greatfet-hardware/gladiolus/(commit log)

2019-01-18 Added AC/DC coupling switch and removed central header
    [gladiolus.kicad_pcb, gladiolus.sch]
2019-01-22 Added transistor notes
    [gladiolus.sch]
2019-01-22 SPI routing
    [foxglove.sch]
2019-01-31 Added AC/DC coupling switch using 74LVC1G3157
    [gladiolus.kicad_pcb, gladiolus.sch]
2019-02-05 Added TODO design notes
    [gladiolus.sch]
2019-02-12 BOM: Changed SMA connectors to RP-SMA and changed SPORT header
    [luckybamboo.kicad_pcb, luckybamboo.sch]
2019-02-28 Gladiolus: Added AD/DC coupling switch, removed DNP components for inversion, added switch to fully turn off TX, routed TX LED current to ADC
    [gladiolus.kicad_pcb, gladiolus.sch]
2019-03-08 Minor change to Gladiolus silkscreen. Began designing Foxglove level shifters / comparators and power supplies.
    [foxglove.sch, gladiolus.kicad_pcb, gladiolus.sch, power_supplies.sch, shifters.sch]
2019-03-11 Changed Changed SPI CS 3 and IRQ1 3 pins, which were interfering with SPIFI. Added DC blocking capacitors near TX switch
    [luckybamboo.kicad_pcb, luckybamboo.sch]
2019-03-18 Lucky Bamboo: Rerouted RX RF signals and rearranged schematic to be consistent with layout. Gladiolus: Routed incomplete signal near TX transistor.
    [gladiolus.kicad_pcb, gladiolus.sch, luckybamboo.kicad_pcb, luckybamboo.sch]
2019-03-26 Replaced rescued symbols on Gladiolus and Lucky Bamboo. Lucky Bamboo: Shorted IRQ1/IRQ2 jumpers to create default connections.
    [gladiolus.kicad_pcb, gladiolus.sch, luckybamboo.kicad_pcb, luckybamboo.sch]
2019-03-27 Lucky Bamboo: Fixed sharp routing corner near splitter to U1
    [luckybamboo.kicad_pcb]
2019-04-09 Corrected component value/manufacturer/part number for C28
    [gladiolus.sch]
2019-04-10 Rerouted ADC trace to improve ground plane connectivity
    [gladiolus.kicad_pcb]
2019-04-11 Changed switch to turn off TX while the DAC is in sleep mode.
    [gladiolus.kicad_pcb, gladiolus.sch]
2019-04-16 Removed several DNP components
    [gladiolus.sch]
2019-04-16 point to new kicad library
2019-04-16 added notes
    [gladiolus.sch]
2019-04-18 Gladiolus: Added design notes. Removed old TX switch and added new TX switch.
    [gladiolus.sch]
2019-04-22 Gladiolus: Added test points, switched connections on RV1, moved TX shutoff switch position, changed RX switch control pin from SPIFI pin J2.37
    [gladiolus.kicad_pcb, gladiolus.sch]
2019-04-24 Changed TX switch control to J1_24 and the ADC clock to J2_P6
    [gladiolus.kicad_pcb, gladiolus.sch]
2019-05-01 Gladiolus: Added EEPROM and changed to default DAC control for second RX gain stage
    [gladiolus.kicad_pcb, gladiolus.sch]
2019-05-07 Added design notes for test points, EEPROM
    [gladiolus.kicad_pcb, gladiolus.sch]
2019-05-13 Added test points, changed EEPROM package and connections.
    [gladiolus.kicad_pcb, gladiolus.sch]
2019-05-14 Added VDBS voltage range note to schematic
    [gladiolus.kicad_pcb, gladiolus.sch]
2019-05-21 Gladiolus: Changed AC/DC coupling note
    [gladiolus.sch]
2019-05-27 split gladiolus into separate repository
    [azalea.kicad_pcb, azalea.sch, begonia.kicad_pcb, begonia.sch, crocus.kicad_pcb, crocus.sch, daffodil.kicad_pcb, daffodil.sch]
2019-05-29 Updated schematic symbols for J7 and mounting holes
    [gladiolus.sch]
2019-06-14 Added I2C DAC and new ACDC coupling switches to schematic. Began routing.
    [gladiolus.kicad_pcb, gladiolus.sch]
2019-06-17 Completed routing for new ACDC coupling switches
    [gladiolus.kicad_pcb, gladiolus.sch]
2019-06-18 Corrected unconnected VCC net
    [gladiolus.kicad_pcb]
2019-06-19 Corrected ACDC switching scheme and moved test point pads.
    [gladiolus.kicad_pcb, gladiolus.sch]
2019-06-25 Simplified BOM by reducing # of different parts
    [gladiolus.kicad_pcb, gladiolus.sch]
2019-06-25 Corrected SS date
    [gladiolus.kicad_pcb]
2019-06-25 Corrected DRC errors (test points on forbidden layers, track clearance)
    [gladiolus.kicad_pcb]
2019-08-01 Added switch to control bonus row ADC connection, pull-ups/downs for switches, removed pot RV2, improved GND/VCC plane connectivity.
    [gladiolus.kicad_pcb, gladiolus.sch]
2019-08-03 remove VBUS bias option for photodiode clean up some of the layout
    [gladiolus.kicad_pcb, gladiolus.sch]
2019-08-13 remove DNP parts R22, R26, R29 clean up some layout
    [gladiolus.kicad_pcb, gladiolus.sch]
2019-08-13 change C30, C31, R21 from 0402 to 0603 clean up more layout
    [gladiolus.kicad_pcb, gladiolus.sch]
2019-08-13 add decoupling caps C35 and C36 for TX LED move U7 add testpoint labels to silkscreen move TP5 from front to back
    [gladiolus.kicad_pcb, gladiolus.sch]
2019-08-13 change default from DC coupling to AC coupling
    [gladiolus.kicad_pcb, gladiolus.sch]
2019-08-13 Added indicator LEDs
    [gladiolus.kicad_pcb, gladiolus.sch]
2019-09-27 Changed VCC/VBUS on silkscreen to +3.3V/+5V; Changed VBUS to +5V in the schematic
    [gladiolus.kicad_pcb, gladiolus.sch]
2020-02-07 Update DNP labels
    [gladiolus.sch]
2020-02-07 Update DNP labels for Jumpers
    [gladiolus.sch]
2020-02-07 Add part number and other fields for D6
    [gladiolus.sch]
2020-02-07 Remove '+' from 3.3V/5V on silkscreen; Change VBUS to +5V in schematic; Resovles #6"
    [gladiolus.kicad_pcb, gladiolus.sch]
2020-02-19 Add LED outlines to silkscreen; Update components to active parts
    [gladiolus.kicad_pcb, gladiolus.sch]
2020-03-02 Update PCB from schematic
    [gladiolus.kicad_pcb]
2020-07-03 adopt OSHWA convention for SPI signal names https://www.oshwa.org/a-resolution-to-redefine-spi-signal-names
    [gladiolus.kicad_pcb, gladiolus.sch]
2021-01-14 connect J7_P10 to RTCX1 instead of GND
    add some silkscreen elements to match neighbor-template
    clean up schematic a bit for readability
    [gladiolus.kicad_pcb, gladiolus.sch]
2021-01-14 update license to CERN-OHL-P v2
    [gladiolus.kicad_pcb, gladiolus.sch]
2021-01-21 correct date on silkscreen
    [gladiolus.kicad_pcb]
