greatfet-hardware/gladiolus/(notices)

Notices in the files:
gladiolus.sch:
Copyright © 2015-2021 Great Scott Gadgets
Licensed under the CERN-OHL-P v2
